stevemegson/Rantoge/pcb/schematic.pdf

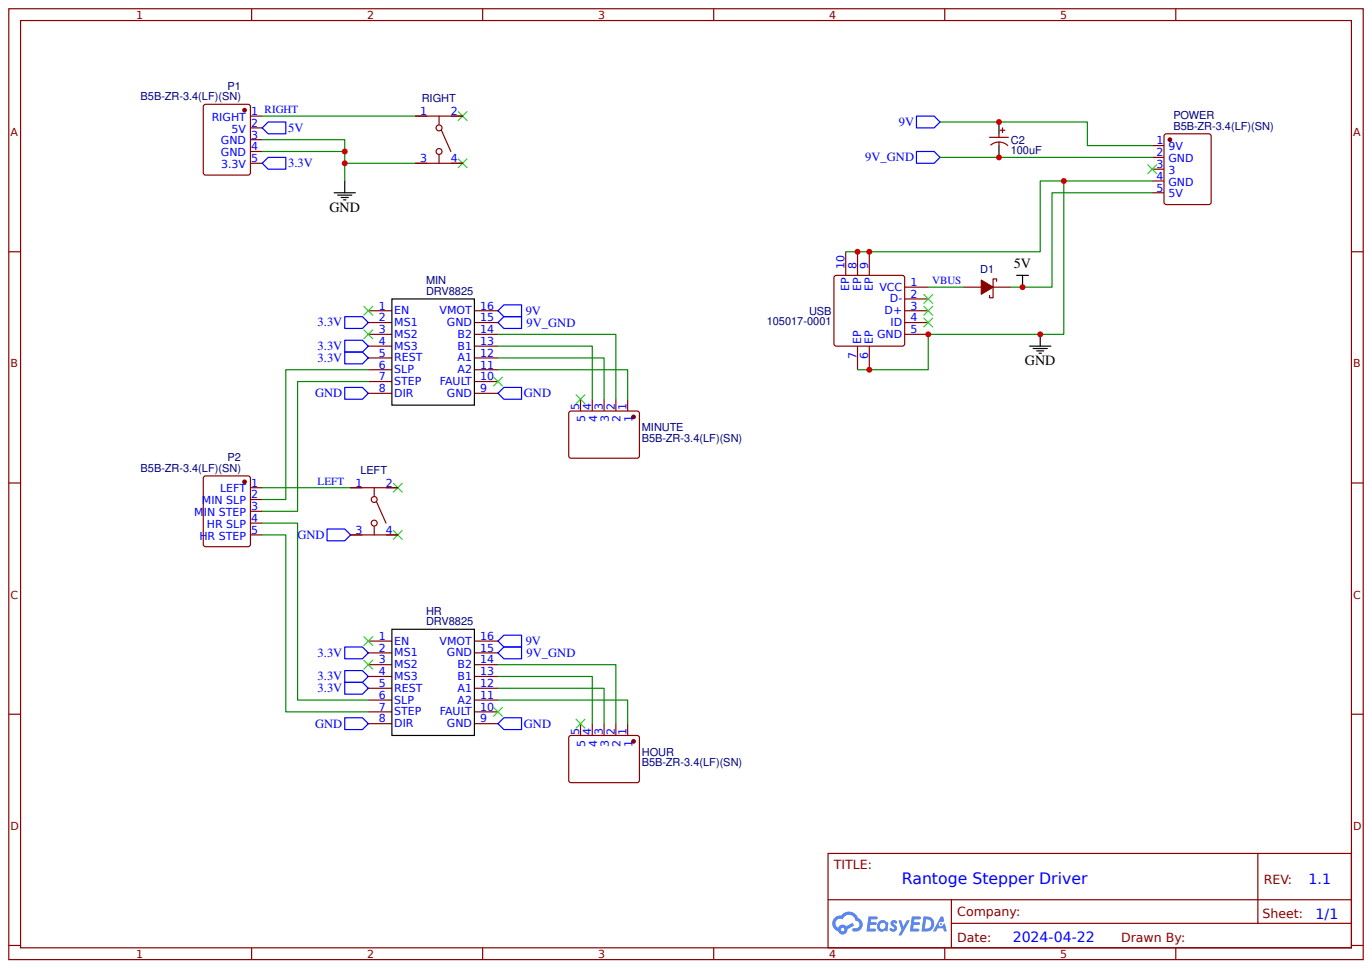
[picture p3: page 1]
TITLE:; Rantoge Stepper Driver; REV: 1.1; Date:; Sheet: 1/1; Drawn By:; Company:; DRV8825; EN 1 MS1 2 MS2 3 MS3 4 REST 5 SLP 6 STEP 7; DIR 8; GND 9 FAULT 10 A2 11 A1 12 B1 13 B2 14 GND 15 VMOT 16; MIN; POWER; 9V 1 GND 2 3 3 GND 4 5V 5; MINUTE ¹ ¹ ² ² ³ ³ ⁴ ⁴ ⁵ ⁵; HOUR ¹ ¹ ² ² ³ ³ ⁴ ⁴ ⁵ ⁵; LEFT 1 MIN SLP 2 MIN STEP 3 HR SLP 4 HR STEP 5; RIGHT 1 5V 2 GND 3 GND 4 3.3V 5; USB; VCC 1 D- 2 D+ 3 ID 4 GND 5; GND; LEFT; RIGHT; VBUS; 9V_GND
