stevemegson/Rantoge/clock/clock.ino

#include "settings.h"

#define VERSION "Version 2.0.1"

void set_rgb(uint8_t r, uint8_t g, uint8_t b) {
#ifdef PIN_RGB
  neopixelWrite(PIN_RGB, r * RGB_BRIGHTNESS / 255, g * RGB_BRIGHTNESS / 255, b * RGB_BRIGHTNESS / 255);
#endif
}

#if ENABLE_BUTTONS == 1
#include <espasyncbutton.hpp>
#endif

#if ENABLE_WIFI == 1
#include <ESPAsyncWebServer.h>
#include "WifiManager.h"
#include "HTML.h"
#endif

#if ENABLE_OTA == 1
#include "src/ElegantOTA/ElegantOTA.h"
#endif

#if ENABLE_GPS == 1
#include "GPS.h"
#endif

#include <Preferences.h>
#include <time.h>
#include <sys/time.h>

#include "ClockManager.h"
#include "TimeZoneManager.h"

ClockManager clock_manager;
TimeZoneManager time_zone_manager;

#if ENABLE_BUTTONS == 1
AsyncEventButton left_button(PIN_LEFT_BUTTON, LOW);
AsyncEventButton right_button(PIN_RIGHT_BUTTON, LOW);

#ifdef PIN_THIRD_BUTTON
AsyncEventButton third_button(PIN_THIRD_BUTTON, LOW);
#endif
#endif

#if ENABLE_WIFI == 1
AsyncWebServer server(80);
AsyncEventSource events("/events");
WifiManager wifi_manager;
#endif

#if ENABLE_GPS == 1
GpsTimeSource gps(&clock_manager);
#endif

typedef void (*logger_cb_t) (const char * format, ...);

void setup() {
  Serial.begin(115200);
  delay(1000);

#if ENABLE_BUTTONS == 1
  start_buttons();
#endif

  clock_manager.set_logger(send_message);
  clock_manager.begin();

#if ENABLE_WIFI == 1
  wifi_manager.begin();
  wifi_manager.start_mdns();

  start_server();
#endif

#if ENABLE_WIFI == 1 && ENABLE_SNTP == 1
  clock_manager.start_ntp(); 
#endif

  if(clock_manager.time_source == NONE) {
    clock_manager.set_current_time(0,0,0);
  }

  time_zone_manager.set_logger(send_message);
  time_zone_manager.begin(&clock_manager);

#if ENABLE_GPS == 1
  gps.begin();
#endif  
}

void loop() {
#if ENABLE_GPS == 1
  gps.tick();
#endif

  clock_manager.tick();

#if ENABLE_OTA == 1  
  ElegantOTA.loop();
#endif  
  
#if ENABLE_TFT == 1  
  delay(100);
#else
  delay(1000);
#endif
}

void send_message(const char *format, ...) {
  char buffer[256];
  va_list args;
  va_start(args, format);
  vsnprintf(buffer, 255, format, args);
  va_end(args);

  Serial.println(buffer);

#if ENABLE_WIFI == 1
  events.send(buffer, "message", millis());
#endif
}

#if ENABLE_WIFI == 1
void start_server() {
  server.on("/", HTTP_GET, [](AsyncWebServerRequest *request) {
    request->send_P(200, "text/html", CONFIG_HTML);
  });

  server.on("/set-displayed", HTTP_POST, [](AsyncWebServerRequest *request) {
    if (request->hasParam("h", true) && request->hasParam("m", true)) {
      int h = request->getParam("h", true)->value().toInt();
      int m = request->getParam("m", true)->value().toInt();

      clock_manager.set_displayed_time(h, m);
      request->send_P(200, "text/plain", "OK");

    } else {
      request->send_P(400, "text/plain", "Missing parameters");
    }
  });

  server.on("/set-time", HTTP_POST, [](AsyncWebServerRequest *request) {
    if (request->hasParam("h", true) && request->hasParam("m", true)) {
      int h = request->getParam("h", true)->value().toInt();
      int m = request->getParam("m", true)->value().toInt();

      clock_manager.set_current_time(h, m, 0);
      clock_manager.time_source = WEB;

      request->send_P(200, "text/plain", "OK");
    } else {
      request->send_P(400, "text/plain", "Missing parameters");
    }
  });

  server.on("/set-date", HTTP_POST, [](AsyncWebServerRequest *request) {
    if (request->hasParam("d", true) && request->hasParam("m", true) && request->hasParam("y", true)) {
      int d = request->getParam("d", true)->value().toInt();
      int m = request->getParam("m", true)->value().toInt();
      int y = request->getParam("y", true)->value().toInt();

      clock_manager.set_current_date(d, m, y);

      request->send_P(200, "text/plain", "OK");
    } else {
      request->send_P(400, "text/plain", "Missing parameters");
    }
  });

  server.on("/set-tz", HTTP_POST, [](AsyncWebServerRequest *request) {
    if (request->hasParam("tz", true)) {
      String tz = request->getParam("tz", true)->value();
      time_zone_manager.set(tz);

      request->send_P(200, "text/plain", "OK");
    } else {
      request->send_P(400, "text/plain", "Missing parameters");
    }
  });

  server.on("/set-wifi", HTTP_POST, [](AsyncWebServerRequest *request) {
    if (request->hasParam("ssid", true) && request->hasParam("password", true)) {
      String ssid = request->getParam("ssid", true)->value();
      String password = request->getParam("password", true)->value();

      wifi_manager.set_credentials(ssid, password);

      request->send(200, "text/plain", ssid);
      delay(3000);
      wifi_manager.begin();

    } else {
      request->send_P(400, "text/plain", "Missing parameters");
    }
  });

  server.on("/set-name", HTTP_POST, [](AsyncWebServerRequest *request) {
    if (request->hasParam("name", true)) {
      String name = request->getParam("name", true)->value();

      wifi_manager.set_name(name);

      request->send(200, "text/plain", name);
      delay(3000);
      wifi_manager.begin();
      wifi_manager.start_mdns();

    } else {
      request->send_P(400, "text/plain", "Missing parameters");
    }
  });

  server.on("/calibrate-hour", HTTP_POST, [](AsyncWebServerRequest *request) {
    clock_manager.request_calibrate_hour();
    request->send_P(200, "text/plain", "OK");
  });

  server.on("/calibrate-minute", HTTP_POST, [](AsyncWebServerRequest *request) {
    clock_manager.request_calibrate_minute();
    request->send_P(200, "text/plain", "OK");
  });

  server.on("/calibrate-end", HTTP_POST, [](AsyncWebServerRequest *request) {
    clock_manager.request_end_calibrate();
    request->send_P(200, "text/plain", "OK");
  });

  server.on("/toggle-demo", HTTP_POST, [](AsyncWebServerRequest *request) {
    clock_manager.toggle_demo();
    request->send_P(200, "text/plain", "OK");
  });

  server.on("/set-mode", HTTP_POST, [](AsyncWebServerRequest *request) {
    if (request->hasParam("m")) {
      int mode = request->getParam("m")->value().toInt();
      clock_manager.set_mode((clock_mode_t)mode);

      request->send_P(200, "text/plain", "OK");
    } else {
      request->send_P(400, "text/plain", "Missing parameters");
    }  });

  events.onConnect([](AsyncEventSourceClient *client) {
    if (client->lastId()) {
      Serial.printf("Client reconnected. Last message ID that it got is: %u\n", client->lastId());
    }

    client->send(VERSION, NULL, millis(), 500);
  });
  server.addHandler(&events);

# if ENABLE_OTA == 1
  ElegantOTA.begin(&server);
# endif

  server.begin();
}
#endif

#if ENABLE_BUTTONS == 1
void start_buttons() {
  ESP_ERROR_CHECK(esp_event_loop_create_default());

  left_button.begin();

  left_button.onLongPress([]() {
    send_message("Left long press");
    clock_manager.request_calibrate_hour();
  });

  left_button.onLongRelease([]() {
    send_message("Left long release");
    clock_manager.request_end_calibrate();
  });

  left_button.onClick([]() {
    send_message("Left click");
    clock_manager.increment_hour();
  });

  left_button.onMultiClick([](int32_t counter) {
    if (counter == 2) {
      send_message("Left double click");
      clock_manager.decrement_hour();
    } else if (counter == 3) {
      send_message("Left triple click");
      clock_manager.toggle_demo();
    }
  });

  left_button.enable();

  right_button.begin();

  right_button.onLongPress([]() {
    send_message("Right long press");
    clock_manager.request_calibrate_minute();
  });

  right_button.onLongRelease([]() {
    send_message("Right long release");
    clock_manager.request_end_calibrate();
  });

  right_button.onClick([]() {
    send_message("Right click");
    clock_manager.increment_minute();
  });

  right_button.onMultiClick([](int32_t counter) {
    if (counter == 2) {
      send_message("Right double click");
      clock_manager.decrement_minute();
    } else if (counter == 3) {
      send_message("Right triple click");
      clock_manager.request_set_minutes();
    }
  });

  right_button.enable();

#ifdef PIN_THIRD_BUTTON
  third_button.begin();

  third_button.onClick([]() {
    send_message("Third click");
  });

  third_button.onLongPress([]() {
    send_message("Third long press");
    clock_manager.request_set_minutes();
  });

  third_button.onLongRelease([]() {
    send_message("Third long release");
  });

  third_button.onMultiClick([](int32_t counter) {
    if (counter == 2) {
      send_message("Third double click");
      clock_manager.toggle_demo();
    }
  });

  third_button.enable();
#endif

}
#endif
