stevemegson/Rantoge/clock/tft_settings.h

#define USER_SETUP_LOADED

#define GC9A01_DRIVER

#define LOAD_GLCD

#define TFT_CS   10
#define TFT_DC   11
#define TFT_MOSI 12
#define TFT_MISO 16
#define TFT_SCLK 13
#define TFT_RST   9
#define TFT_BL   -1

#define LOAD_GLCD

#define SMOOTH_FONT

//#define SPI_FREQUENCY  80000000
#define SPI_FREQUENCY      27000000
#define SPI_READ_FREQUENCY  5000000
