stevemegson/Rantoge/(commit log)

2024-05-02 PCB files
2024-05-12 Correct stepper connections on PCB
2024-05-12 Adjust displayed time with buttons
2024-05-15 Fix pin initialisation and getting local time without SNTP
    [ClockManager.cpp, ClockManager.h, StepperDriver.cpp, clock.ino, settings.h]
2024-06-04 Add SecondsDisplay wirth dummy pin assignments
2024-07-01 Fix time zone check for ENABLE_WIFI
    [TimeZoneManager.cpp]
2024-09-09 Support arduino-esp32 3.x
2024-09-27 Support ESP32S3 and TMC2208
2024-09-28 Pin assignments
2024-09-28 Third button support
2024-09-28 Set wifi power
2024-10-01 RGB status LED
2024-10-01 Third button functions
2024-12-03 Fix test for waiting
    [ClockManager.cpp, WifiManager.cpp]
